LEDs-by-glowingkitty/GlowTower/README.md

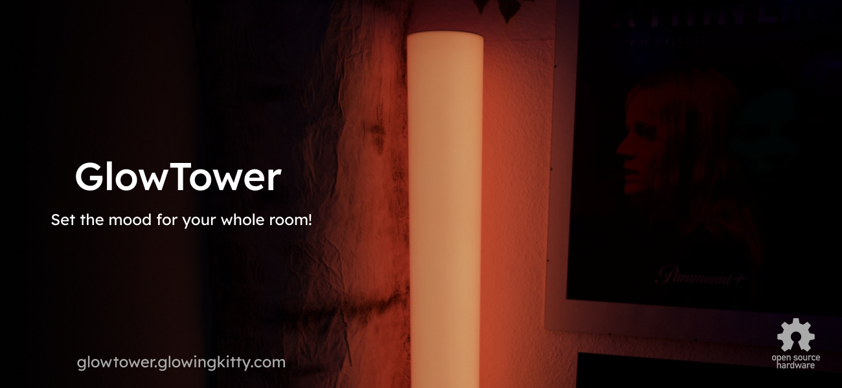
[picture p1: glowtower.jpg]
GlowTower


## What is this project?

A beautiful looking LED lamp for lighting up your home and setting the mood.

## Links

- [Shop](https://shop.glowingkitty.com/products/glowtower)
- [More details](https://glowingkitty.com/glowtower)
- [Tech specs](https://glowingkitty.com/glowtower/specs)
- [FAQ](https://glowingkitty.com/glowtower/faq)
- [Documents](https://glowingkitty.com/glowtower/docs)
- [3D files](https://glowingkitty.com/glowtower/3d)
- [PCB files](https://glowingkitty.com/glowtower/pcb)
