LEDs-by-glowingkitty/GlowTower/elec/layout/button_pcb/button-pcb_back.jpg

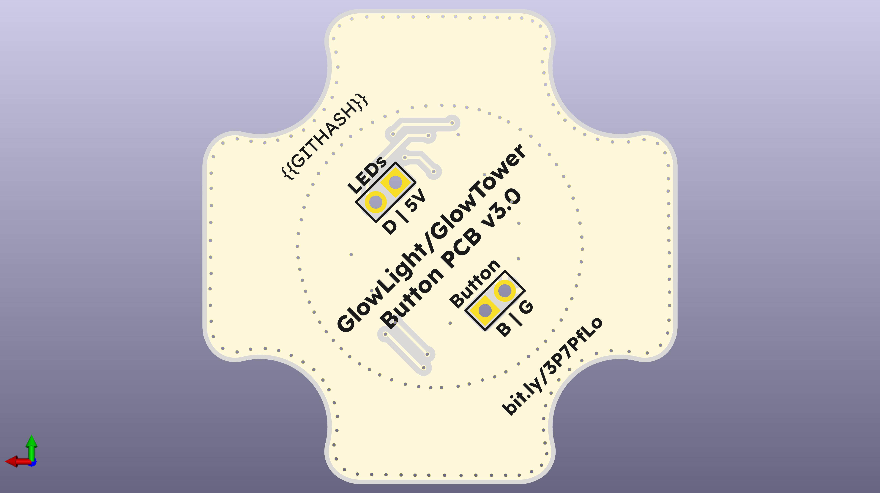
elec/layout/button_pcb/button-pcb_back.jpg
