LEDs-by-glowingkitty/GlowTower/elec/layout/button_pcb/button-pcb_front.jpg

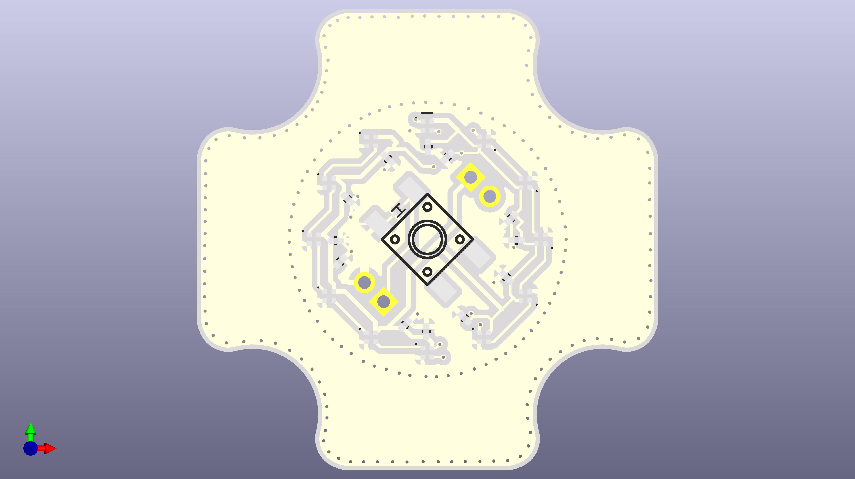
elec/layout/button_pcb/button-pcb_front.jpg
