LEDs-by-glowingkitty/GlowTower/elec/layout/default/pcb_back.jpg

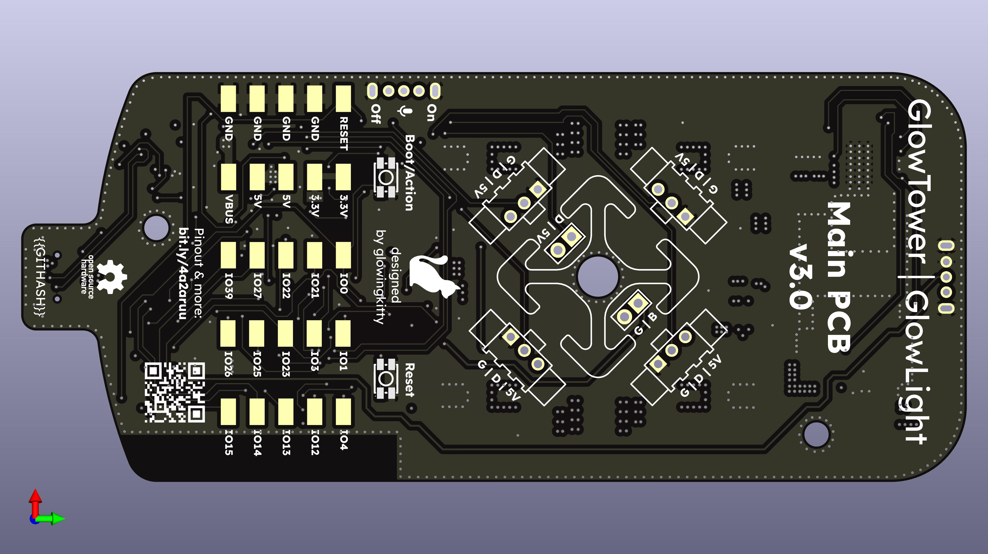
elec/layout/default/pcb_back.jpg
