LEDs-by-glowingkitty/GlowTower/elec/layout/default/pcb_front.jpg

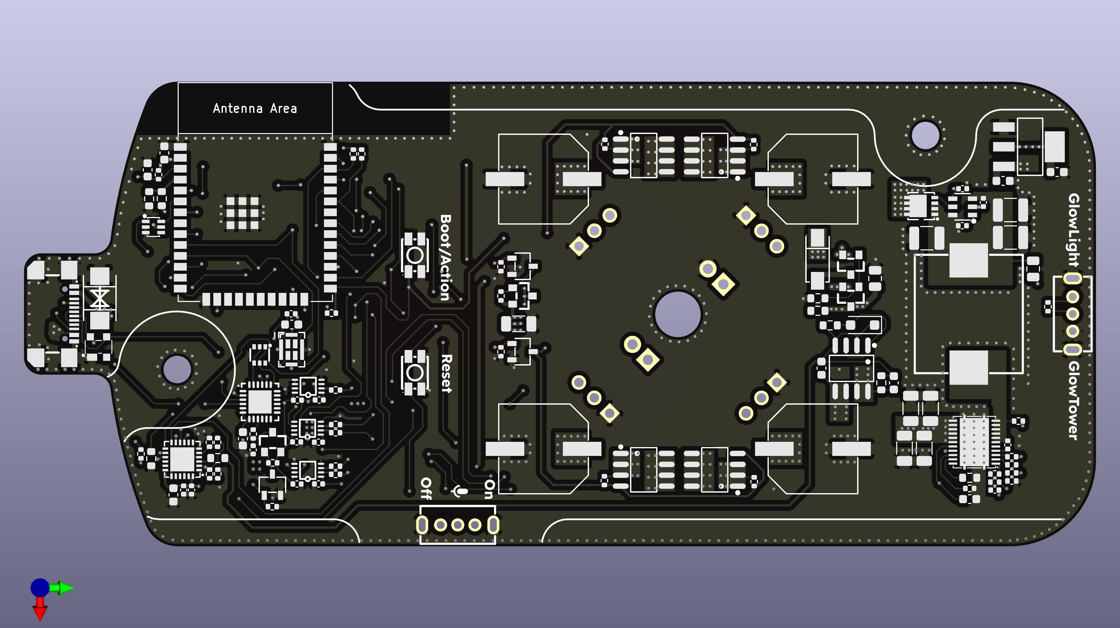
elec/layout/default/pcb_front.jpg
