LEDs-by-glowingkitty/GlowTower/images/glowtower_buttonpress.jpg

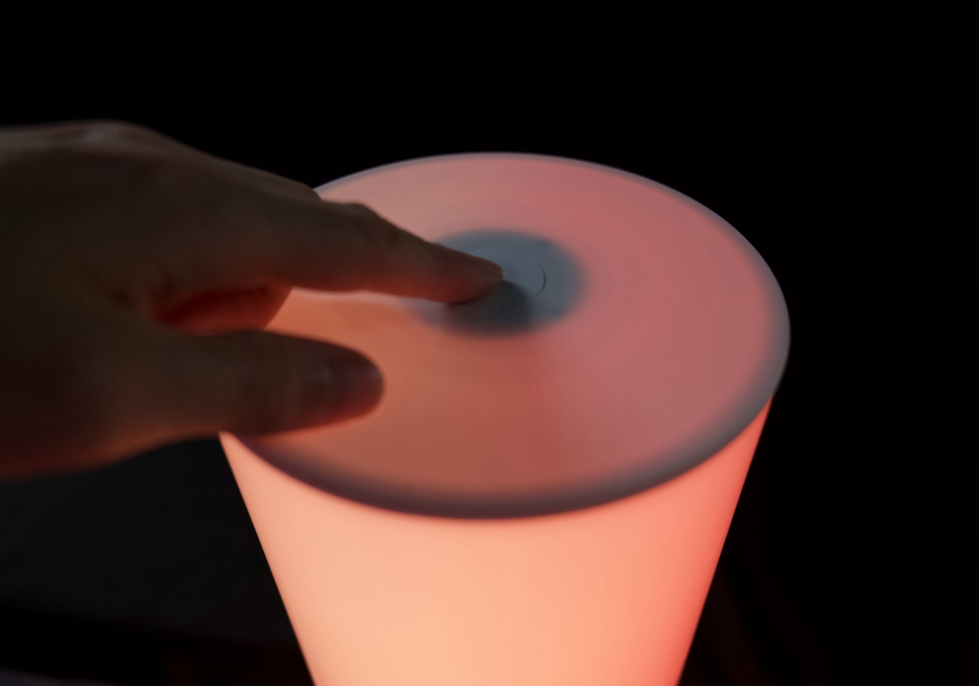
images/glowtower_buttonpress.jpg
