LEDs-by-glowingkitty/GlowTower/images/glowtower_fullcolor.jpg

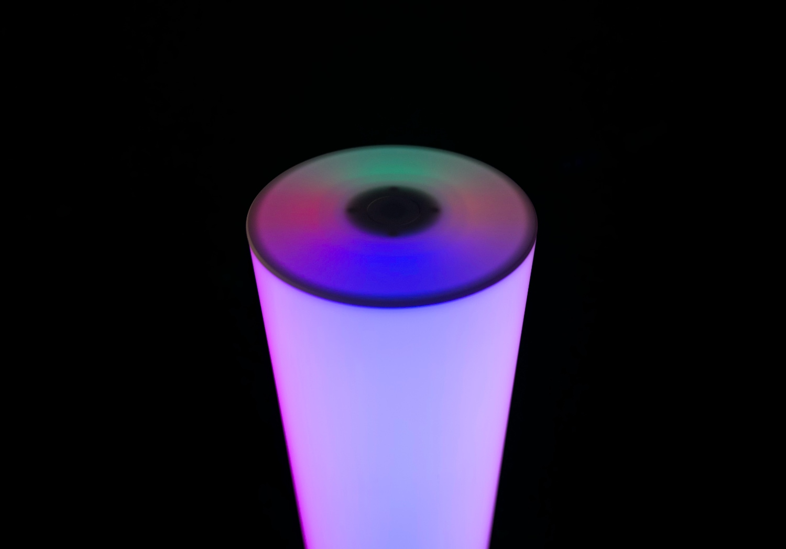
images/glowtower_fullcolor.jpg
