LEDs-by-glowingkitty/GlowTower/images/glowtower_headervideo.jpg

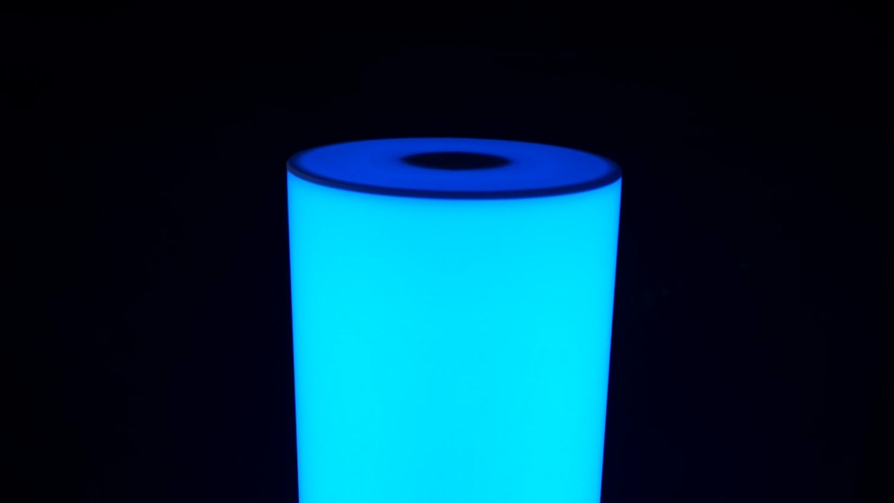
images/glowtower_headervideo.jpg
