LEDs-by-glowingkitty/GlowTower/images/glowtower_main_picture.jpg

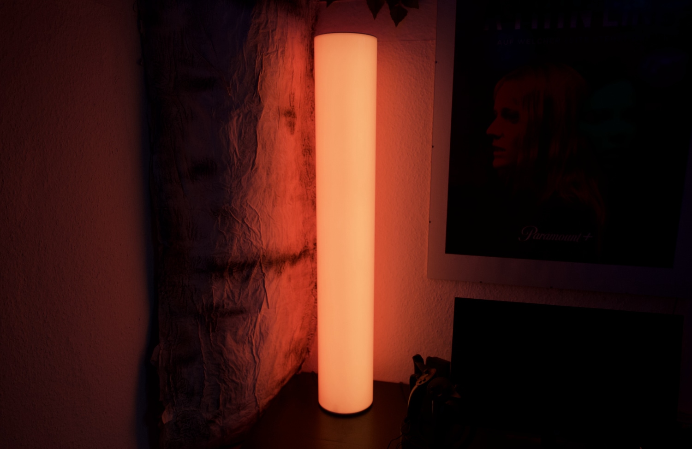
images/glowtower_main_picture.jpg
