LEDs-by-glowingkitty/GlowTower/images/glowtower_manyeffects.jpg

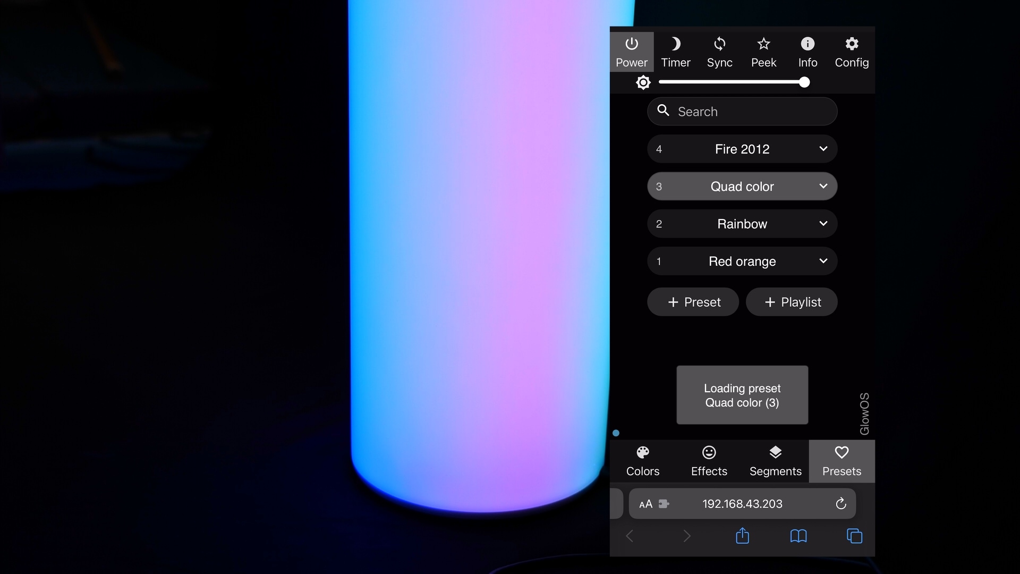
images/glowtower_manyeffects.jpg
