LEDs-by-glowingkitty/GlowTower/elec/layout/default/layout_shapes/main_pcb_shape.dxf

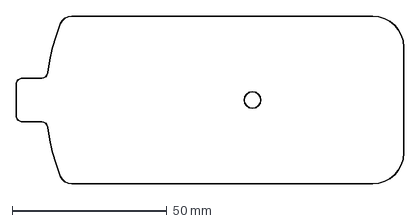
[picture p11: CAD file, 2024-03-04]
elec/layout/default/layout_shapes/main_pcb_shape.dxf
125.0 x 54.1 mm
