LEDs-by-glowingkitty/GlowTower/3D files/case/bottom_case.stl

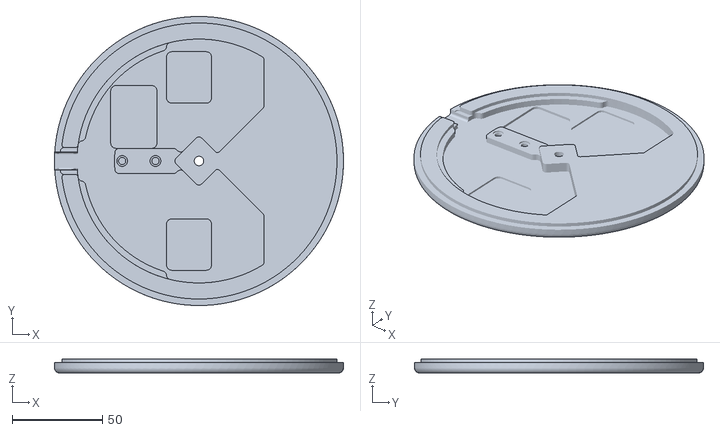
[picture p12: CAD file, 2023-09-27]
3D files/case/bottom_case.stl
160.0 x 160.0 x 8.00
