LEDs-by-glowingkitty/GlowTower/elec/layout/default/layout_shapes/pcb_case_contact.dxf

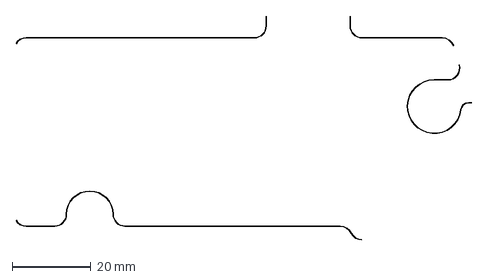
[picture p13: CAD file, 2024-03-07]
elec/layout/default/layout_shapes/pcb_case_contact.dxf
115.6 x 56.8 mm
