LEDs-by-glowingkitty/GlowTower/mech/template_outline.dxf

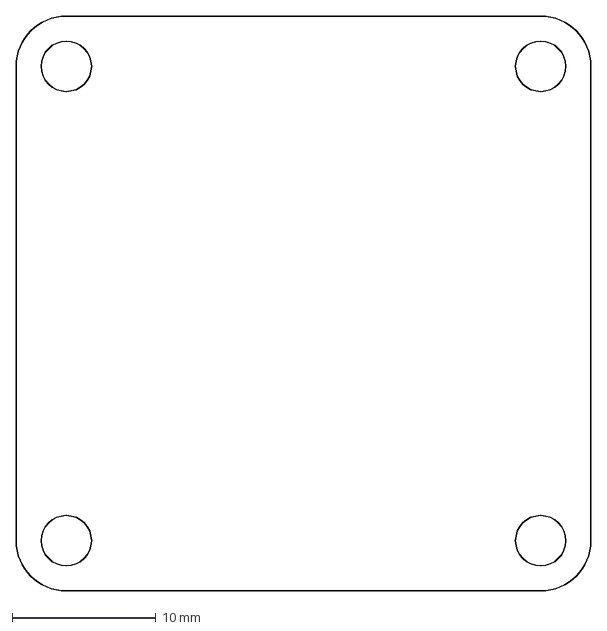
[picture p14: CAD file, 2024-02-06]
mech/template_outline.dxf
40.0 x 40.0 mm
