LEDs-by-glowingkitty/GlowTower/3D files/case/top_acrylic_part.stl

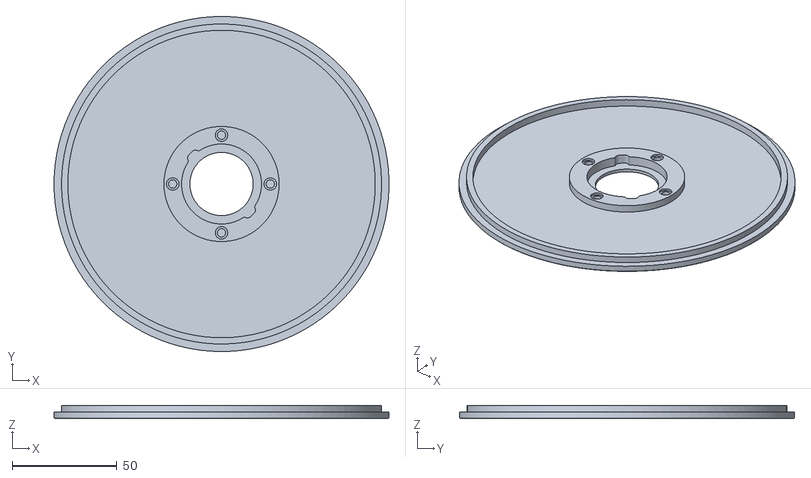
[picture p15: CAD file, 2023-09-27]
3D files/case/top_acrylic_part.stl
160.0 x 160.0 x 6.00
