LEDs-by-glowingkitty/GlowTower/elec/layout/default/layout_shapes/pcb_case_contact_helper.dxf

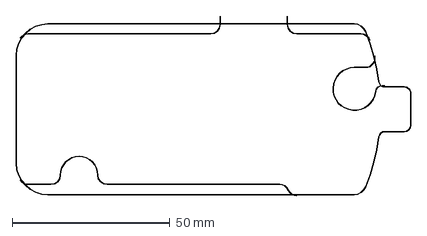
[picture p16: CAD file, 2024-03-07]
elec/layout/default/layout_shapes/pcb_case_contact_helper.dxf
125.0 x 56.8 mm
