LEDs-by-glowingkitty/GlowTower/mech/template_40x40.dxf

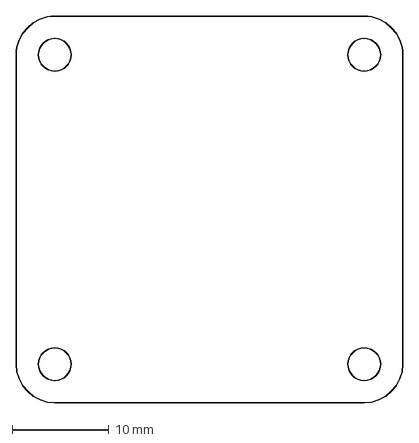
[picture p17: CAD file, 2024-02-06]
mech/template_40x40.dxf
40.0 x 40.0 mm
