LEDs-by-glowingkitty/GlowTower/elec/layout/default/layout_shapes/led_strip_connector_indicator.dxf

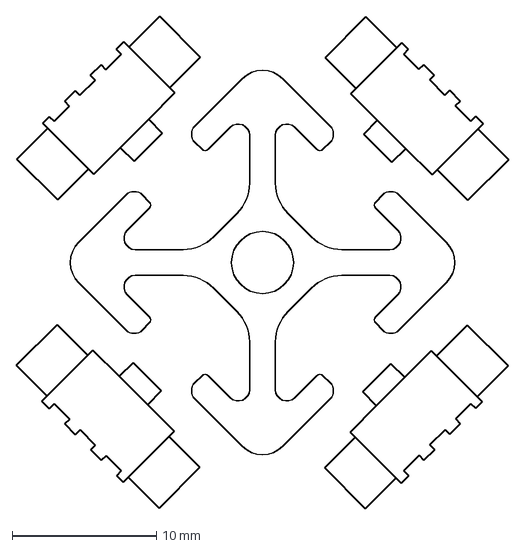
[picture p18: CAD file, 2024-03-07]
elec/layout/default/layout_shapes/led_strip_connector_indicator.dxf
34.1 x 34.1 mm
