LEDs-by-glowingkitty/GlowTower/3D files/case/button.stl

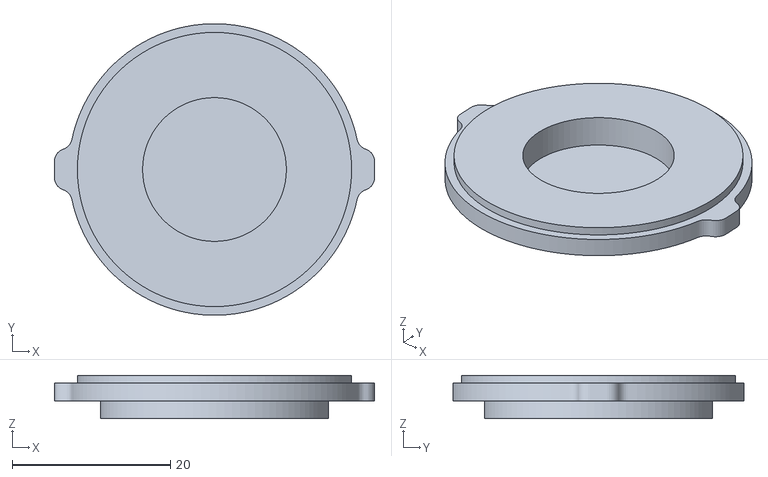
[picture p19: CAD file, 2023-09-27]
3D files/case/button.stl
40.5 x 36.9 x 5.50
