LEDs-by-glowingkitty/GlowTower/elec/layout/default/layout_shapes/pin_header_positions.dxf

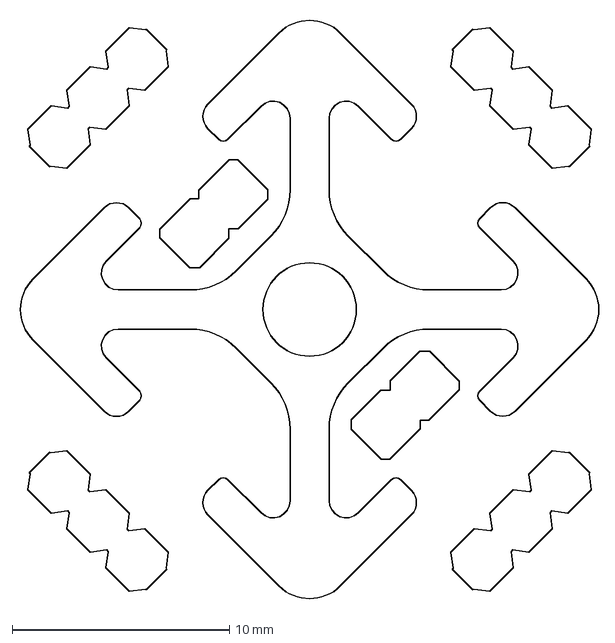
[picture p20: CAD file, 2024-03-05]
elec/layout/default/layout_shapes/pin_header_positions.dxf
26.8 x 27.0 mm
