LEDs-by-glowingkitty/GlowTower/3D files/case/top_case_to_aluminum_connector.stl

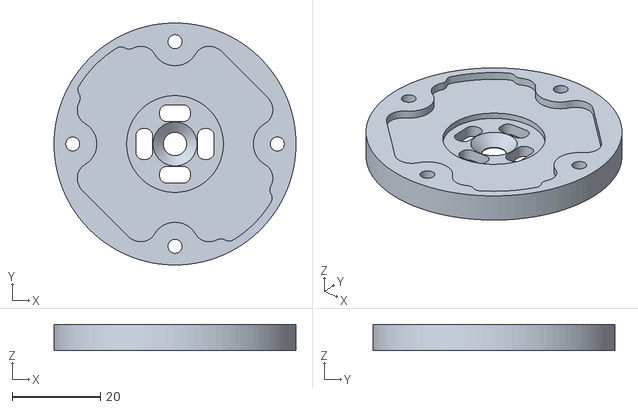
[picture p21: CAD file, 2023-09-27]
3D files/case/top_case_to_aluminum_connector.stl
55.0 x 55.0 x 6.00
