LEDs-by-glowingkitty/GlowTower/elec/layout/default/layout_shapes/led connectors position silkscreen.dxf

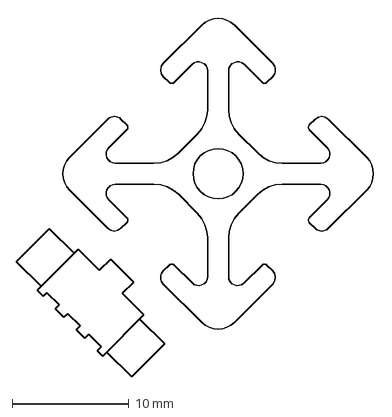
[picture p22: CAD file, 2024-02-27]
elec/layout/default/layout_shapes/led connectors position silkscreen.dxf
30.8 x 30.9 mm
