LEDs-by-glowingkitty/GlowTower/elec/layout/default/layout_shapes/aluminum tube inner shape.dxf

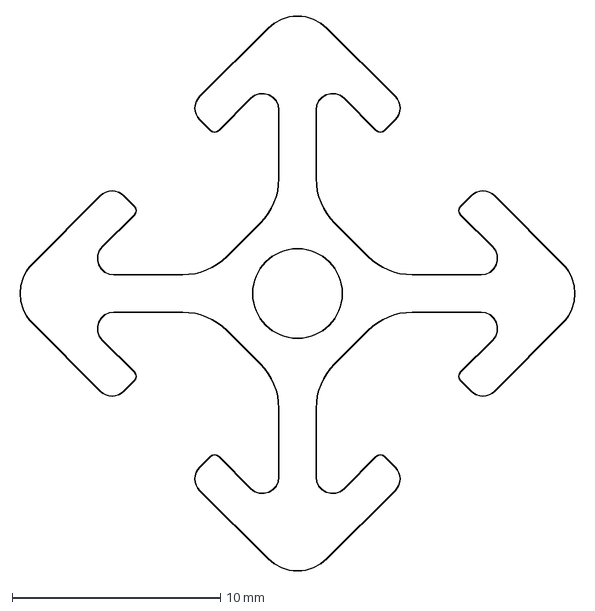
[picture p23: CAD file, 2024-02-27]
elec/layout/default/layout_shapes/aluminum tube inner shape.dxf
27.0 x 26.6 mm
