LEDs-by-glowingkitty/GlowTower/elec/layout/default/layout_shapes/aluminum tube outer shape.dxf

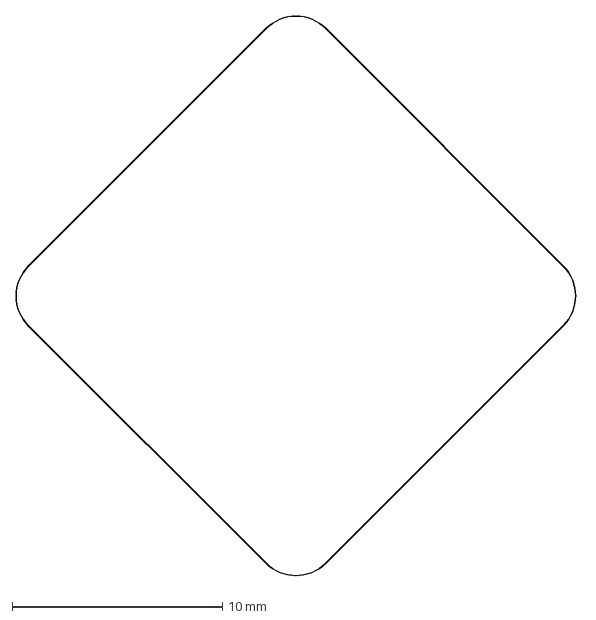
[picture p24: CAD file, 2024-02-27]
elec/layout/default/layout_shapes/aluminum tube outer shape.dxf
26.8 x 26.8 mm
