LEDs-by-glowingkitty/GlowTower/elec/layout/default/layout_shapes/aluminum tube shape.dxf

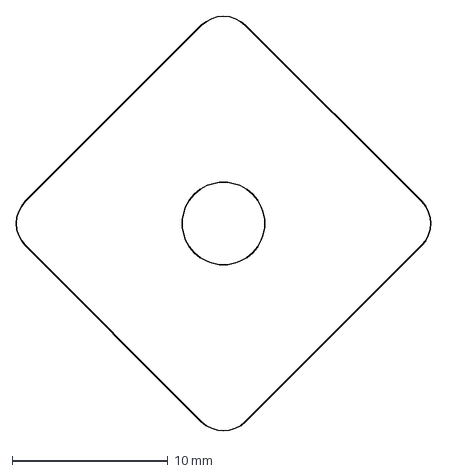
[picture p25: CAD file, 2024-02-27]
elec/layout/default/layout_shapes/aluminum tube shape.dxf
26.8 x 26.8 mm
