LEDs-by-glowingkitty/GlowTower/(list of files, cad)

Other CAD files:
elec/layout/default/main-pcb.step
3D files/step files/MainPCB.step
3D files/step files/ButtonPCB.step
elec/layout/button_pcb/button-pcb.step
3D files/case/top_acrylic_part_no_button.stl
3D files/step files/GlowTower.step
