LEDs-by-glowingkitty/GlowTower/(commit log)

2021-09-21 added files from first prototype
    [Lid.3mf, stand cover.3mf, stand.3mf]
2021-11-06 added manual, updated 3d files
    [Lid.3mf, bottom case.stl, bottom cover.stl, stand cover.3mf, stand.3mf, top case.stl]
2021-11-09 made aluminium tube shorter
    [bottom case.stl, top case.stl]
2021-11-09 updated dimensions of aluminium tube
2021-11-16 fix wire connection image
2021-11-22 increased space for esp32 and wago connector
    [bottom case.stl]
2021-12-11 fix wrong analog pin
2021-12-18 replaced USB-C board with USB-C PD board
    [bottom case.stl, bottom cover.stl]
2022-02-25 start working on custom pcb
    [GlowTowerPCB-CuBottom.gbr, GlowTowerPCB-CuTop.gbr, GlowTowerPCB-EdgeCuts.gbr, GlowTowerPCB-MaskBottom.gbr, GlowTowerPCB-MaskTop.gbr, GlowTowerPCB-NPTH.drl, GlowTowerPCB-PTH.drl, GlowTowerPCB-PasteBottom.gbr]
2022-02-28 started adding receiver mode & connector pcb
    [GlowTowerPCB.kicad_pcb, GlowTowerPCB.kicad_sch]
2022-03-10 finished GlowTower PCB v1.0 beta 1
    [GlowTowerPCB-CuBottom.gbr, GlowTowerPCB-CuTop.gbr, GlowTowerPCB-EdgeCuts.gbr, GlowTowerPCB-MaskBottom.gbr, GlowTowerPCB-MaskTop.gbr, GlowTowerPCB-NPTH.drl, GlowTowerPCB-PTH.drl, GlowTowerPCB-PasteBottom.gbr]
2022-03-11 update screenshots of PCBs
    [GlowTowerPCB.kicad_pcb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]
2022-03-14 added links to schematics
2022-03-14 added stencil
    [stencil.stl]
2022-03-17 updated case, based on new PCB
    [aluminium tube blocker.stl, bottom case.stl, bottom cover.stl, bottom_case.stl, top case.stl, top_case.stl]
2022-03-17 added links to 3d models and pcb files
2022-03-17 added pcb export
2022-03-25 added pcb stencils
    [GlowTowerPCB-CuBottom.gbr, GlowTowerPCB-CuTop.gbr, GlowTowerPCB-EdgeCuts.gbr, GlowTowerPCB-MaskBottom.gbr, GlowTowerPCB-MaskTop.gbr, GlowTowerPCB-NPTH.drl, GlowTowerPCB-PTH.drl, GlowTowerPCB-PasteBottom.gbr]
2022-03-26 added 3d printed case files
2022-04-23 updated pcb design (in progress)
    [GlowLEDsPCB-CuBottom.gbr, GlowLEDsPCB-CuTop.gbr, GlowLEDsPCB-EdgeCuts.gbr, GlowLEDsPCB-MaskBottom.gbr, GlowLEDsPCB-MaskTop.gbr, GlowLEDsPCB-NPTH.drl, GlowLEDsPCB-PTH.drl, GlowLEDsPCB-PasteBottom.gbr]
2022-05-05 redesigned GlowTower/GlowLight main pcb
    [GlowLEDsPCB-CuBottom.gbr, GlowLEDsPCB-CuTop.gbr, GlowLEDsPCB-EdgeCuts.gbr, GlowLEDsPCB-MaskBottom.gbr, GlowLEDsPCB-MaskTop.gbr, GlowLEDsPCB-NPTH.drl, GlowLEDsPCB-PTH.drl, GlowLEDsPCB-PasteBottom.gbr]
2022-05-05 updated readme and stencil for connector
    [GlowTower_LED_connector_PCB.kicad_pcb]
2022-06-04 replaced mic and levelshifter
    [GlowTowerPCB-CuBottom.gbr, GlowTowerPCB-CuTop.gbr, GlowTowerPCB-EdgeCuts.gbr, GlowTowerPCB-MaskBottom.gbr, GlowTowerPCB-MaskTop.gbr, GlowTowerPCB-NPTH.drl, GlowTowerPCB-PTH.drl, GlowTowerPCB-PasteBottom.gbr]
2022-06-21 added release candidate 1 update
    [GlowTowerPCB-CuBottom.gbr, GlowTowerPCB-CuTop.gbr, GlowTowerPCB-EdgeCuts.gbr, GlowTowerPCB-MaskBottom.gbr, GlowTowerPCB-MaskTop.gbr, GlowTowerPCB-NPTH.drl, GlowTowerPCB-PTH.drl, GlowTowerPCB-PasteBottom.gbr]
2022-06-23 fixed SMD nut footprint
    [GlowTowerPCB-CuBottom.gbr, GlowTowerPCB-CuTop.gbr, GlowTowerPCB-EdgeCuts.gbr, GlowTowerPCB-MaskBottom.gbr, GlowTowerPCB-MaskTop.gbr, GlowTowerPCB-NPTH.drl, GlowTowerPCB-PTH.drl, GlowTowerPCB-PasteBottom.gbr]
2022-06-27 fixed capacitor value
    [GlowTowerPCB-CuBottom.gbr, GlowTowerPCB-CuTop.gbr, GlowTowerPCB-EdgeCuts.gbr, GlowTowerPCB-MaskBottom.gbr, GlowTowerPCB-MaskTop.gbr, GlowTowerPCB-NPTH.drl, GlowTowerPCB-PTH.drl, GlowTowerPCB-PasteBottom.gbr]
2022-06-27 fixed parts selection
    [GlowTowerPCB-CuBottom.gbr, GlowTowerPCB-CuTop.gbr, GlowTowerPCB-EdgeCuts.gbr, GlowTowerPCB-MaskBottom.gbr, GlowTowerPCB-MaskTop.gbr, GlowTowerPCB-NPTH.drl, GlowTowerPCB-PTH.drl, GlowTowerPCB-PasteBottom.gbr]
2022-06-30 improved connection to top case, added new glowtower design
    [GlowTower_LED_connector_PCB-CuBottom 2.gbr, GlowTower_LED_connector_PCB-CuBottom.gbr, GlowTower_LED_connector_PCB-CuTop 2.gbr, GlowTower_LED_connector_PCB-CuTop.gbr, GlowTower_LED_connector_PCB-EdgeCuts 2.gbr, GlowTower_LED_connector_PCB-EdgeCuts.gbr, GlowTower_LED_connector_PCB-MaskBottom 2.gbr, GlowTower_LED_connector_PCB-MaskBottom.gbr]
2022-07-03 made bottom case lighter and use less material
    [bottom_case.stl]
2022-07-04 added schottky diode to protect usb-c port
    [GlowTowerPCB-CuBottom.gbr, GlowTowerPCB-CuTop.gbr, GlowTowerPCB-EdgeCuts.gbr, GlowTowerPCB-MaskBottom.gbr, GlowTowerPCB-MaskTop.gbr, GlowTowerPCB-NPTH.drl, GlowTowerPCB-PTH.drl, GlowTowerPCB-PasteBottom.gbr]
2022-07-05 added second schottky diode for reduced heat
    [GlowTowerPCB-CuBottom.gbr, GlowTowerPCB-CuTop.gbr, GlowTowerPCB-EdgeCuts.gbr, GlowTowerPCB-MaskBottom.gbr, GlowTowerPCB-MaskTop.gbr, GlowTowerPCB-NPTH.drl, GlowTowerPCB-PTH.drl, GlowTowerPCB-PasteBottom.gbr]
2022-07-07 fixed hole size for screw inserts
    [top_case.stl]
2022-07-10 added disconnect LEDs from power via software
    [GlowTowerPCB-CuBottom.gbr, GlowTowerPCB-CuTop.gbr, GlowTowerPCB-EdgeCuts.gbr, GlowTowerPCB-MaskBottom.gbr, GlowTowerPCB-MaskTop.gbr, GlowTowerPCB-NPTH.drl, GlowTowerPCB-PTH.drl, GlowTowerPCB-PasteBottom.gbr]
2022-08-24 updated 3D printed parts
    [GlowTowerPCB-CuBottom.gbr, GlowTowerPCB-CuTop.gbr, GlowTowerPCB-EdgeCuts.gbr, GlowTowerPCB-MaskBottom.gbr, GlowTowerPCB-MaskTop.gbr, GlowTowerPCB-NPTH.drl, GlowTowerPCB-PTH.drl, GlowTowerPCB-PasteBottom.gbr]
2022-12-03 added pinout
    [GlowTowerPCB.kicad_pcb]
2023-03-01 cleaned up repo
    [ButtonPCB.step, GlowTower.blend, GlowTower.step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]
2023-03-01 updated 3d models and folder structure
    [ButtonPCB.step, GlowTower.blend, GlowTower.step, MainPCB.step, bottom_case.stl, bottom_cover.stl, top_case.stl, top_case_button.stl]
2023-03-07 updated pcbfiles
2023-09-25 removed currently not working links
2023-09-27 updated 3d models, documents, pcb files
    [Button PCB.kicad_pcb, Button PCB.kicad_sch, Button PCB.step, GlowTower.blend, GlowTower.step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]
2023-09-27 updated 3d files, documents, pcbfiles lists
2024-02-06 started redesign of pcb and added test for atopile
    [Button PCB.kicad_pcb, Button PCB.kicad_sch, Button PCB.step, ButtonPCB.step, MainPCB.kicad_sch, glowtower-main-pcb.kicad_pcb, glowtower-main-pcb.kicad_sch, main_pcb_shape.dxf]
2024-02-07 added button pcb as atopile design
    [button-pcb.kicad_pcb, button-pcb.kicad_sch, glowtower-main-pcb.kicad_pcb, main-pcb.kicad_pcb, main-pcb.kicad_sch, template_40x40.dxf, template_outline.dxf]
2024-02-08 started working on main pcb
2024-02-08 added pin description
2024-02-08 added ESD protection diode and made progress with CP2102N
2024-02-08 connected CP2102N power, voltage divider, pull up resistor and caps
2024-02-08 finished (for now) CP2102N, also updated pin names
2024-02-08 added 5A capable USB-C connector to main pcb
2024-02-08 seperated caps and resistors more
2024-02-08 add caps and resistors for USB PD ic
2024-02-09 added more missing resistors for USB PD IC
    [MainPCB.kicad_sch]
2024-02-14 connected pullup/pulldown resistors to request 9V 2A
2024-02-14 split voltage divider into seperate modules for better readability
2024-02-14 connected caps and resistors to USB PD ic and renamed voltage divider modules
2024-02-14 connect the load switches of the USB PD ic
2024-02-14 connected load switches
2024-02-14 added 20v max and fine setting for amps to 0
2024-02-14 seperated ti buck converter
2024-02-15 added buck converter mosfets and inductor
2024-02-15 started adding parts for buck converter
2024-02-15 added all components for buck converter
2024-02-16 renamed module for buck converter
2024-02-16 added connections for buck converter
2024-02-16 removed not used dependencies and updated layout file
    [main-pcb.kicad_pcb]
2024-02-16 added 3.3V LDO
2024-02-16 added levelshifters for leds
2024-02-19 added power mosfets to turn on/off leds (since they consume 1mA each off)
2024-02-19 renamed buttons and splitted esp32 indo module and component
2024-02-19 added caps for LEDs
2024-02-19 splitted CP2102N into module, added new components to pcb layout
    [main-pcb.kicad_pcb]
2024-02-20 added solderpads
    [main-pcb.kicad_pcb]
2024-02-20 added pin headers
2024-02-20 restructured main pcb overview
2024-02-20 connected the esp32 to power and usb to serial
    [main-pcb.kicad_pcb]
2024-02-20 simplified power connections
    [main-pcb.kicad_pcb]
2024-02-20 connected boot/action button and inverter
2024-02-20 connect power mosfet
2024-02-20 added connections for caps and pin headers
2024-02-20 renamed pads
    [main-pcb.kicad_pcb]
2024-02-21 improved code readability
    [main-pcb.kicad_pcb]
2024-02-21 moved the boot button and pull up to esp32 module
2024-02-21 clean up
    [main-pcb.kicad_pcb]
2024-02-21 added draft pcb shape
    [main-pcb.kicad_pcb]
2024-02-21 improved comments for esp32
2024-02-21 updated connections
    [main-pcb.kicad_pcb]
2024-02-21 fix uart connection
2024-02-21 turn on cp2102N only if usb power is connected, not if external power
2024-02-21 added slider switch to select glowlight or glowtower mode
    [main-pcb.kicad_pcb]
2024-02-21 moved usb serial power mosfet outside of cp2101n
    [main-pcb.kicad_pcb]
2024-02-21 renamed caps and added comments
    [main-pcb.kicad_pcb]
2024-02-22 added I2C pull up resistors and made vbus voltage readout easier accessible
2024-02-22 added missing diode footprint
    [main-pcb.kicad_pcb]
2024-02-22 added comments and switched to 6 layer pcb design
    [main-pcb.kicad_pcb]
2024-02-22 replaced esp32 footprint with smaller one and added step 3d model
    [main-pcb.kicad_pcb]
2024-02-22 replaced usb connector 3d model with step
    [main-pcb.kicad_pcb]
2024-02-23 improved readability of buck converter code
    [main-pcb.kicad_pcb]
2024-02-23 added min 0.3mm board edge clearance
2024-02-23 replaced 3d model of button, made pcb black, added gnd layer
    [main-pcb.kicad_pcb]
2024-02-23 CYPD3177 & CP2102N: updated footprint and replaced 3d model with .step
    [main-pcb.kicad_pcb]
2024-02-23 removed not used 3d model
    [main-pcb.kicad_pcb]
2024-02-23 clean up cp2102N code, moved 3.3v ldo on pcb
    [main-pcb.kicad_pcb]
2024-02-23 started to rearrange components, separating data & power
    [main-pcb.kicad_pcb]
2024-02-23 improved readability of the code, added microphone power slider switch
    [main-pcb.kicad_pcb]
2024-02-23 updated footprint for slider switch
    [main-pcb.kicad_pcb]
2024-02-23 completed todo's: - direct connection pads -> not needed - test adding caps for leds -> yep, seems fine - also added additional todo's
2024-02-23 solved todo: reverse polarity for leds not needed
2024-02-26 added more comments to n channel mosfets
2024-02-26 updated to KiCad 8.0
    [main-pcb.kicad_pcb]
2024-02-26 updated comments regarding ideal diode
2024-02-26 moved comments regarding reverse flow protection
2024-02-26 added schottky diode for reverse flow protection and moved files
    [main-pcb.kicad_pcb]
2024-02-26 renamed schottky diode
2024-02-26 updated comments on ideal diode
2024-02-26 replaced big caps 3d models with .step files
    [main-pcb.kicad_pcb]
2024-02-26 updated inductor 3d model to .step
    [main-pcb.kicad_pcb]
2024-02-26 replaced pin headers 3d models with .step files
    [main-pcb.kicad_pcb]
2024-02-26 updated SOP8 mosfet footprints & 3d models to .step
    [main-pcb.kicad_pcb, main-pcb.step]
2024-02-26 updated usb-c port footprint to move it further to pcb edge
2024-02-26 replaced LDO converter 3d model with .step
    [main-pcb.kicad_pcb]
2024-02-26 fixed big cap position, replaced 3d model of small buttons to .step
    [main-pcb.kicad_pcb]
2024-02-26 added silkscreen for switches
    [main-pcb.kicad_pcb]
2024-02-26 replaced schottky diode 3d model with .step
    [main-pcb.kicad_pcb]
2024-02-26 updated button code for readability
    [button-pcb.kicad_pcb]
2024-02-26 improved readability of leds
2024-02-26 seperated led into module and component
2024-02-26 replaced 3d model for buck converter ic with .step
    [main-pcb.kicad_pcb]
2024-02-26 replaced buck converter ic 3d model with .step
    [main-pcb.kicad_pcb]
2024-02-26 replaced 3d model of mosfet with .step
    [main-pcb.kicad_pcb]
2024-02-27 replaced 3d model of esd protection with .step, changed connections of esd protection for better routing on pcb
    [main-pcb.kicad_pcb]
2024-02-27 updated position of parts on pcb
    [main-pcb.kicad_pcb]
2024-02-27 replaced levelshifter 3d model with .step
    [main-pcb.kicad_pcb]
2024-02-27 replaced 3d model of protection diode with .step
    [main-pcb.kicad_pcb]
2024-02-27 replaced mosfet 3d model with .step
    [main-pcb.kicad_pcb]
2024-02-27 replaced mic 3d model with .step
    [main-pcb.kicad_pcb]
2024-02-27 replaced inverter 3d model to .step
    [main-pcb.kicad_pcb]
2024-02-27 replaced 3d model of auto reset circuit to .step, rotated pcb design by 90 degrees
    [main-pcb.kicad_pcb]
2024-02-27 fixed links to 3d models in footprints
    [main-pcb.kicad_pcb]
2024-02-27 made progress with designing pcb layout
    [aluminum tube inner shape.dxf, aluminum tube outer shape.dxf, aluminum tube shape.dxf, led connectors position silkscreen.dxf, main-pcb.kicad_pcb, main-pcb.step]
2024-02-28 rearranged buck converter TPS40305DRCR code, started adding ideal diode LM74700QDBVRQ1
    [main_pcb_shape.dxf]
2024-02-28 added input caps for reverse flow protection and more comments
2024-02-28 renamed G, S, D pins to GATE, SOURCE, DRAIN of mosfets
2024-02-28 renamed pins of mosfets
2024-02-28 added TVS diode for protection from voltage spikes from USB-C connector
2024-02-28 added Cout cap for ideal diode circuit
2024-02-28 updated pcb connections, added script to create single file with all .ato files, for LLMs
    [main-pcb.kicad_pcb]
2024-02-28 replaced vin and vout with power_in and power_out
2024-02-28 added missing drain for power mosfet
    [main-pcb.kicad_pcb]
2024-02-29 improved/fixed code of LDO converter
    [main-pcb.kicad_pcb]
2024-02-29 updated esp32 code structure
2024-02-29 improved readability of power mosfet circuit
2024-02-29 improved switch code and added missing datasheet for transistor
2024-02-29 fixed load switches
2024-02-29 improved readability of voltage divider
2024-02-29 improved button layout readability
2024-02-29 improved readability of main pcb code
2024-02-29 made it more clear that IO0 and action button are pressed the same way
2024-02-29 changed used pins on ESP32, added todo to test all pins
2024-02-29 updated pcb layout
    [main-pcb.kicad_pcb]
2024-02-29 added missing uart connection to usb to serial
2024-03-01 connect tvs diode to USB-C power, not to VBUS output of USB PD IC
    [main-pcb.kicad_pcb]
2024-03-01 further improved readability
    [main-pcb.kicad_pcb]
2024-03-01 seperated solder pads for better readability
    [main-pcb.kicad_pcb]
2024-03-01 made buck converter code more readable
2024-03-01 improved naming of esp32 module
2024-03-01 moved parts and grouped
    [main-pcb.kicad_pcb]
2024-03-01 renamed voltage dividers for USB PD IC and moved and grouped parts
    [main-pcb.kicad_pcb]
2024-03-01 added todo's, moved parts on pcb
    [main-pcb.kicad_pcb]
2024-03-01 added alternative pin names for esp32
2024-03-01 added detailed checklist for testing pins
    [main-pcb.kicad_pcb]
2024-03-01 added ESD protection diode to button pcb
2024-03-01 added buck converter which I already used in previous versions
2024-03-04 started replacing buck converter with one that I already used, is cheaper and more available and more efficient
2024-03-04 added description to buck converter pins
2024-03-04 added missing components to buck converter (next, create and import them)
2024-03-04 added correct cin_caps for buck converter
2024-03-04 added ren resistor
2024-03-04 added en pin voltage divider resistors
2024-03-04 replaced seperate resistor .ato files with generic resistor + specs
2024-03-04 added voltage and series values to caps (let's see if it compiles)
2024-03-04 further updated buck converter
2024-03-04 added resistors for programming buck output voltage
2024-03-04 added Rpg and Rmodeg resistors
2024-03-04 finished adding parts for buck converter
2024-03-04 updated layout positions
    [main-pcb.kicad_pcb]
2024-03-04 moved components arround in layout
    [main-pcb.kicad_pcb]
2024-03-04 increased main pcb shape size and moved components, added holes for screws
    [main-pcb.kicad_pcb, main_pcb_shape.dxf]
2024-03-05 fixed common gnd issue
    [main-pcb.kicad_pcb]
2024-03-05 moved parts and alligned arround center
    [main-pcb.kicad_pcb, pin_header_positions.dxf]
2024-03-05 updated gnd layers and layer settings
    [main-pcb.kicad_pcb]
2024-03-05 replaced buck converter 3d model with .step
    [main-pcb.kicad_pcb]
2024-03-05 moved big caps for button pcb led ring to button pcb
    [button-pcb.kicad_pcb, main-pcb.kicad_pcb]
2024-03-05 added reverse polarity protection to button pcb leds
2024-03-06 fixed caps footprints and missing gnd connection for button pcb
2024-03-06 removed reverse polarity protection again from button pcb, because it didn't made any sense (both pin headers were 5V, so it wouldn't have worked).
    [button-pcb.kicad_pcb]
2024-03-06 updated button pcb and replaced 3d models with .step files
    [button-pcb.kicad_pcb, button-pcb.step]
2024-03-06 added githash to button pcb
    [button-pcb.kicad_pcb]
2024-03-06 moved parts on main pcb
    [main-pcb.kicad_pcb]
2024-03-06 added missing .step 3d models for main pcb
    [main-pcb.kicad_pcb]
2024-03-06 worked on boot and reset button positions, replaced pcb holes with m3/m5 footprints
    [main-pcb.kicad_pcb, main-pcb.step]
2024-03-06 moved led ring capacitor back to main pcb, added mounting holes to .ato file
    [button-pcb.kicad_pcb, main-pcb.kicad_pcb, main-pcb.step]
2024-03-07 added power mosfet for button leds
    [main-pcb.kicad_pcb]
2024-03-07 replaced dual p channel mosfet for safe 5v power with two cheaper and smaller p channel mosfets
    [main-pcb.kicad_pcb]
2024-03-07 reverse polarity protection for led strips won't work, so removed todo
2024-03-07 improved uart connections
2024-03-07 positioned solder pads in pcb layout
    [main-pcb.kicad_pcb]
2024-03-07 updated position and silkscreen for solderpads
    [led_strip_connector_indicator.dxf, main-pcb.kicad_pcb, pcb_case_contact.dxf, pcb_case_contact_helper.dxf]
2024-03-08 fix microphone power connection
2024-03-08 updated button pcb, removed caps
    [button-pcb.kicad_pcb, button-pcb.step]
2024-03-08 added missing silkscreen, updated pin connections
    [main-pcb.kicad_pcb]
2024-03-08 remove unconnected pins from esp32 module
2024-03-08 updated 3d model of main pcb
    [main-pcb.step]
2024-03-08 added additional boot and reset buttons for pcb backside
2024-03-08 started pcb routing
    [main-pcb.kicad_pcb]
2024-03-11 rearranged vias on pcb edge, rearranged buck converter part positions
    [main-pcb.kicad_pcb]
2024-03-11 added missing check for USB PD output voltage
2024-03-11 mostly connected USB PD IC traces
    [main-pcb.kicad_pcb]
2024-03-11 added traces for usb to serial IC
    [main-pcb.kicad_pcb]
2024-03-11 made sure one pin of 3rd levelshifter is not used
2024-03-11 made progreess with pcb routing
    [main-pcb.kicad_pcb]
2024-03-12 made progress with routing pcb
    [main-pcb.kicad_pcb]
2024-03-12 made routing progress
    [main-pcb.kicad_pcb]
2024-03-13 tested safe 5v power output, updated pcb traces
2024-03-14 added releases to new seperate folder
    [Button PCB.kicad_pcb, Button PCB.kicad_sch, GlowTowerPCB.kicad_pcb, GlowTowerPCB.kicad_sch, MainPCB.kicad_pcb, MainPCB.kicad_sch, button-pcb.kicad_pcb, main_pcb_shape.dxf]
2024-03-14 added updated 3d model of main pcb
    [main-pcb.step]
2024-03-14 removed schottky diode for safe 5v output, not needed it seems
    [button-pcb.kicad_pcb]
2024-03-15 added production and assembly instructions
2024-03-19 updated ci to kicad 8
2024-04-17 fixed wrong connection between USB PD Safe 5V PWR EN and GND, added more schematic documentation from USB PD IC
    [button-pcb.kicad_pcb]
2024-04-17 added cc1 and cc2 caps which were missing from PCB design, added more ideas how to fix SAFE 5V PWR EN problem
2024-04-17 switched to .value for resistors and caps
2024-05-10 added inrush current limiting resistors + cc line pull downs (need to test)
